sezgynus/peacock_tail_brd/Board.step

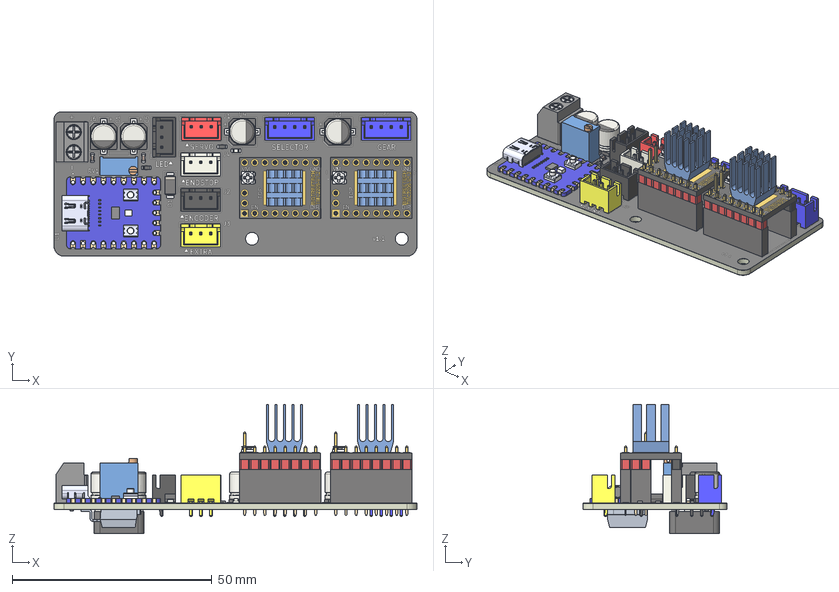
[picture p1: CAD file, 2026-09-23]
Board.step
90.8 x 36.1 x 32.3 mm
Screw Terminal Block 5mm 2-way
R_0805_2012Metric x 4
JST_XH_B4B-XH-A_1x04_P2.50mm_Vertical_Blue x 2
JST_XH_B3B-XH-A_1x03_P2.50mm_Vertical_Red
PinSocket_1x08_P2.54mm_Vertical x 4
TMC2209_board x 2
Pin_Header_1x2_red x 2
Pin_Header_1x8_red x 2
Pin_Header_1x8_black x 2
EVM-3E___ _________ x 2
TMC2209_heatsink x 2
PinSocket_1x02_P2.54mm_Vertical x 2
LED_0603_1608Metric
CP_Elec_6.3x7.7 x 4
JST_XH_B3B-XH-A_1x03_P2.50mm_Vertical
JST_XH_B3B-XH-A_1x03_P2.50mm_Vertical_Yellow
R_0603_1608Metric x 2
D_SMA
C_0603_1608Metric x 2
RP2040-ZERO
JST_XH_B3B-XH-A_1x03_P2.50mm_Vertical_Black x 2
Potentiometer_Bourns_3296W_Vertical
L_Bourns_SRR1260
Board 1.34.1
peacock_tail_brd_copper
peacock_tail_brd_pad
peacock_tail_brd_via
peacock_tail_brd_silkscreen x 2
peacock_tail_brd_soldermask x 2
peacock_tail_brd_PCB
