sezgynus/peacock_tail_brd/peacock_tail_brd.kicad_pcb

## KiCad design peacock_tail_brd.kicad_pcb (2026-09-23)

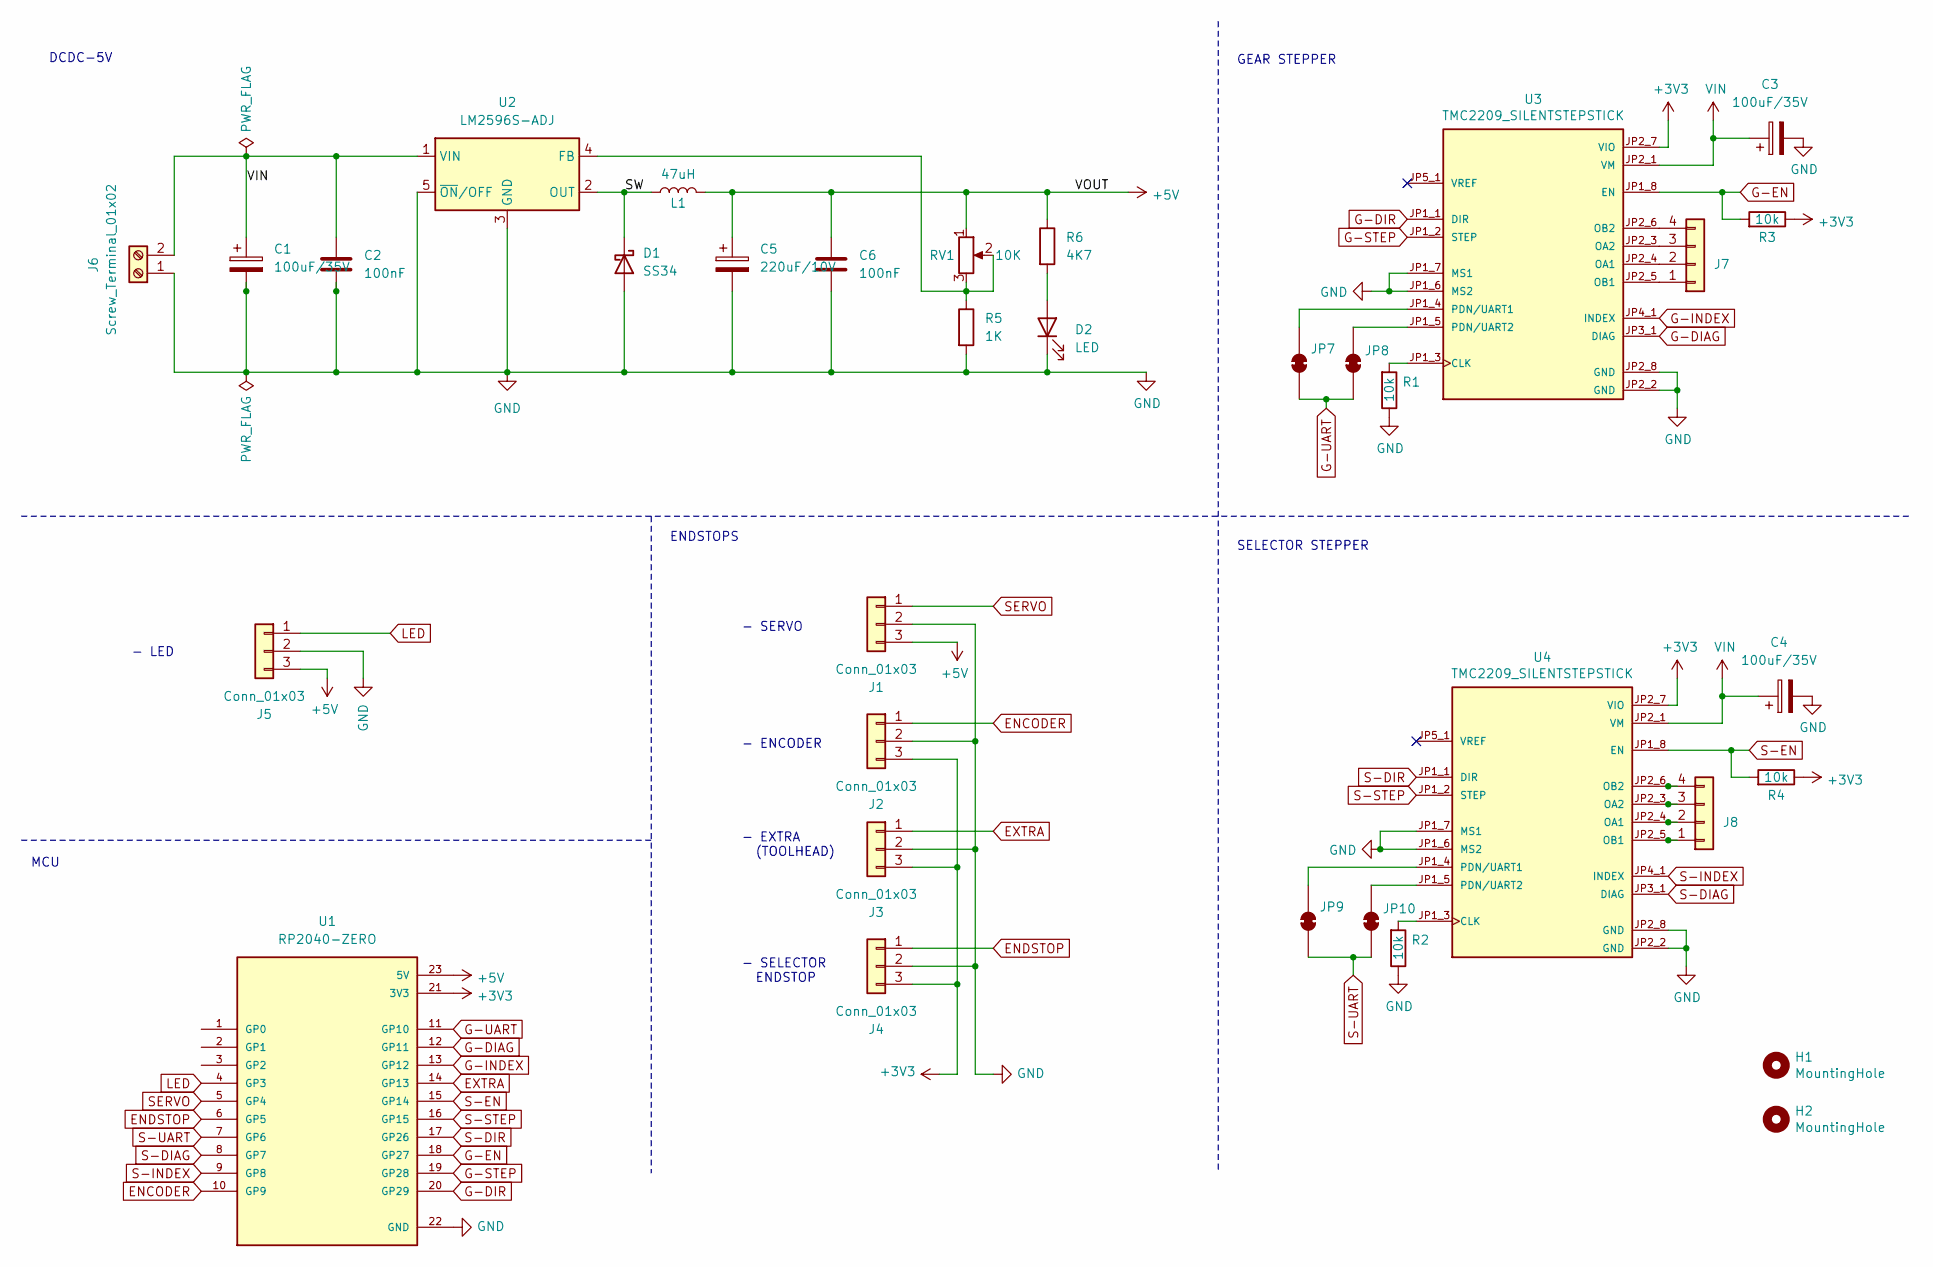
[picture p2: schematic peacock_tail_brd.kicad_sch, PEACOCK TAIL BRD]

Parts:
C1, C3, C4: 100uF/35V; CP_Elec_6.3x7.7; MPN C72478
C2, C6: 100nF; C_0603_1608Metric
C5: 220uF/10V; CP_Elec_6.3x7.7; MPN C881921
D1: SS34; D_SMA; MPN C8678
D2: LED; LED_0603_1608Metric
H1, H2: MountingHole; MountingHole_3.2mm_M3
J1: Conn_01x03; JST_XH_B3B-XH-A_1x03_P2.50mm_Vertical; MPN C95019
J2, J5: Conn_01x03; JST_XH_B3B-XH-A_1x03_P2.50mm_Vertical; MPN C565985
J3: Conn_01x03; JST_XH_B3B-XH-A_1x03_P2.50mm_Vertical; MPN C22388509
J4: Conn_01x03; JST_XH_B3B-XH-A_1x03_P2.50mm_Vertical; MPN C2316
J6: Screw_Terminal_01x02; TerminalBlock_bornier-2_P5.08mm_2; MPN C709041
J7, J8: Conn_01x04; JST_XH_B4B-XH-A_1x04_P2.50mm_Vertical; MPN C566014
JP7, JP9: SolderJumper_2_Open; SolderJumper-2_P1.3mm_Bridged_RoundedPad1.0x1.5mm
JP8, JP10: SolderJumper_2_Bridged; SolderJumper-2_P1.3mm_Bridged_RoundedPad1.0x1.5mm
L1: 47uH; L_Bourns_SRR1208_12.7x12.7mm
R1, R2, R3, R4: 10k; R_0805_2012Metric
R5: 1K; R_0603_1608Metric
R6: 4K7; R_0603_1608Metric
RV1: 10K; Potentiometer_Bourns_3296W_Vertical; MPN C48601077
U1: RP2040-ZERO; MODULE_RP2040-ZERO; PARTREV NA
U2: LM2596S-ADJ; TO-263-5_TabPin3; MPN C2977091
U3, U4: TMC2209_SILENTSTEPSTICK; MODULE_TMC2209_SILENTSTEPSTICK; PARTREV v11

Connections:
+3V3: J2.3, J3.3, J4.3, R3.2, R4.2, U1.21 (3V3), U3.JP2_7 (VIO), U4.JP2_7 (VIO)
+5V: C5.1, C6.1, J1.3, J5.3, L1.2, R6.1, RV1.1, U1.23 (5V)
/SW: D1.1 (K), L1.1, U2.2 (OUT)
ENCODER: J2.1, U1.10 (GP9)
ENDSTOP: J4.1, U1.6 (GP5)
EXTRA: J3.1, U1.14 (GP13)
G-DIAG: U1.12 (GP11), U3.JP3_1 (DIAG)
G-DIR: U1.20 (GP29), U3.JP1_1 (DIR)
G-EN: R3.1, U1.18 (GP27), U3.JP1_8 (EN)
G-INDEX: U1.13 (GP12), U3.JP4_1 (INDEX)
G-STEP: U1.19 (GP28), U3.JP1_2 (STEP)
G-UART: JP7.1 (A), JP8.2 (B), U1.11 (GP10)
GND: C1.2, C2.2, C3.2, C4.2, C5.2, C6.2, D1.2 (A), D2.1 (K), J1.2, J2.2, J3.2, J4.2, J5.2, J6.1, R1.2, R2.2, R5.2, U1.22 (GND), U2.3 (GND), U2.5 (~ON/OFF), U3.JP1_6 (MS2), U3.JP1_7 (MS1), U3.JP2_2 (GND), U3.JP2_8 (GND), U4.JP1_6 (MS2), U4.JP1_7 (MS1), U4.JP2_2 (GND), U4.JP2_8 (GND)
LED: J5.1, U1.4 (GP3)
unnamed: D2.2 (A), R6.2
unnamed: J7.1, U3.JP2_5 (OB1)
unnamed: J7.2, U3.JP2_4 (OA1)
unnamed: J7.3, U3.JP2_3 (OA2)
unnamed: J7.4, U3.JP2_6 (OB2)
unnamed: J8.1, U4.JP2_5 (OB1)
unnamed: J8.2, U4.JP2_4 (OA1)
unnamed: J8.3, U4.JP2_3 (OA2)
unnamed: J8.4, U4.JP2_6 (OB2)
unnamed: JP7.2 (B), U3.JP1_4 (PDN/UART1)
unnamed: JP8.1 (A), U3.JP1_5 (PDN/UART2)
unnamed: JP9.2 (B), U4.JP1_4 (PDN/UART1)
unnamed: JP10.1 (A), U4.JP1_5 (PDN/UART2)
unnamed: R5.1, RV1.2, RV1.3, U2.4 (FB)
unnamed: R1.1, U3.JP1_3 (CLK)
unnamed: R2.1, U4.JP1_3 (CLK)
S-DIAG: U1.8 (GP7), U4.JP3_1 (DIAG)
S-DIR: U1.17 (GP26), U4.JP1_1 (DIR)
S-EN: R4.1, U1.15 (GP14), U4.JP1_8 (EN)
S-INDEX: U1.9 (GP8), U4.JP4_1 (INDEX)
S-STEP: U1.16 (GP15), U4.JP1_2 (STEP)
S-UART: JP9.1 (A), JP10.2 (B), U1.7 (GP6)
SERVO: J1.1, U1.5 (GP4)
VIN: C1.1, C2.1, C3.1, C4.1, J6.2, U2.1 (VIN), U3.JP2_1 (VM), U4.JP2_1 (VM)

Notes on the sheet:
GEAR STEPPER
- EXTRA (TOOLHEAD)
SELECTOR STEPPER
- SELECTOR ENDSTOP
ENDSTOPS
- SERVO
- LED
MCU
- ENCODER
DCDC-5V

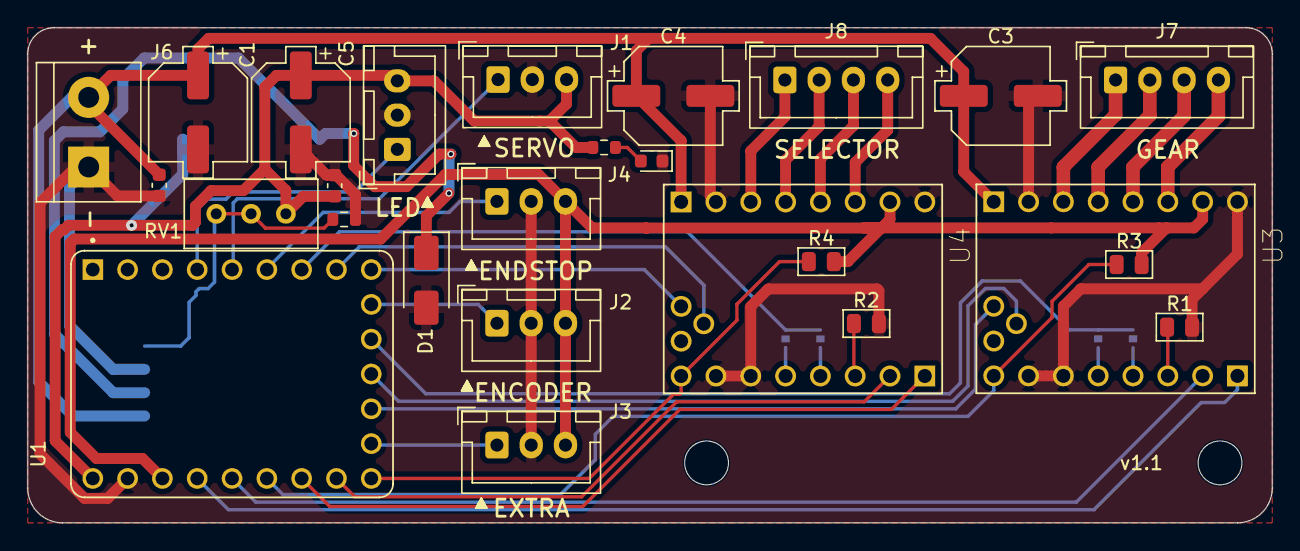
[picture p3: board peacock_tail_brd.kicad_pcb from above]

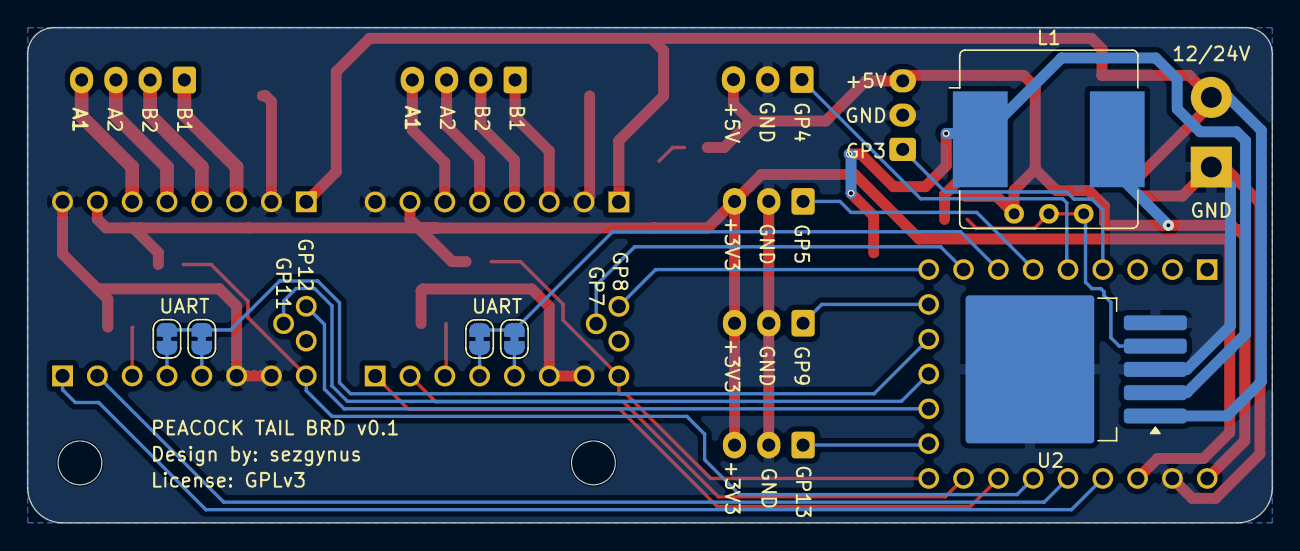
[picture p4: board peacock_tail_brd.kicad_pcb from below]

Board: 2 copper layers, 90.8 x 36.1 mm, 34 parts (6 on the bottom side), 38 nets.
