sezgynus/peacock_tail_brd/(notices)

Notices in the files:
peacock_tail_brd.kicad_pcb:
License: GPLv3
